marinarierav/DriveArt/docs/report_sprint2.pdf

## DRIVE ART

### Sprint #2

### 8 Mayo 2019

### Stefany Ariana Chóez Bolaños 1459134

### Daniel Panadero Espinosa 1458674

### César Valcarce Pagán 1388811 Marina Riera Velasco 1457466

# Contents

1

RLP - Computer Engineering. UAB (Barcelona) 2018-2019 | Drive Art

## Descripción del proyecto

Drive Art es un coche robot (con cierta autonomía) que permite dibujar con los gestos que hagamos con la cabeza (dibujo en físico). Drive Art dispone de dos sensores de ultrasonidos que permitirá que el coche evite obstáculos para no chocarse. Por otra parte, teniendo en cuenta que el dibujo que se realizará con los gestos puede no ser perfecto, ya que este proyecto se ha pensado para una posible utilidad para las personas con paraplejia, se realzará un filtrado para arreglar el dibujo que se haya hecho y se mostrará por pantalla el resultado final.

## Componentes electrónicos

- Arduino nano
- HC-SR04 ultrasonic sensor
- Motor shield l298n
- Motores DC y ruedas
- Baterías AA recargables
- Base para baterías
- Módulo wifi
- Micro servo SG90
- Cables

Page 2 of 11

RLP - Computer Engineering. UAB (Barcelona) 2018-2019 | Drive Art

## Esquema Hardware

A continuación, se muestra el esquema de conexiones de nuestro robot.

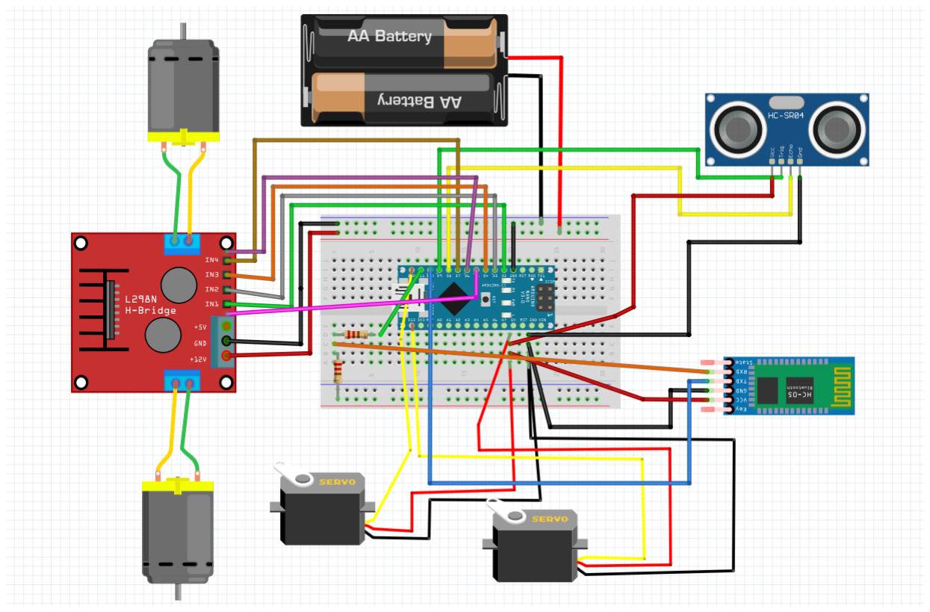
[picture p12: figure]

Figure 1: Esquema de connexiones de los componentes.

Page 3 of 11

RLP - Computer Engineering. UAB (Barcelona) 2018-2019 | Drive Art

## Arquitectura Software

A continuación, se muestran los distintos módulos software que usaremos y cómo se comunican entre ellos y con los distintos dispositivos.


Figure 2: Esquema de módulos software.

Page 4 of 11

RLP - Computer Engineering. UAB (Barcelona) 2018-2019 | Drive Art

## Otros Esquemas: sketch del robot

A continuación, se muestra un sketch inicial del concepto de nuestro robot, con las medidas de los componentes.


Figure 3: Sketch inicial del robot (cotas en milímetros).

Page 5 of 11

RLP - Computer Engineering. UAB (Barcelona) 2018-2019 | Drive Art

## Contribuciones

Como se ha comentado en la descripción del proyecto, DriveArt consiste en un coche robot que permita dibujar, y que se controla mediante los gestos de la cabeza. Está basado no en un sólo proyecto, sinó en una combinación de varios (consultar sección referencias). De modo que nuestra principal contribución ha sido la de unificar todos estos proyectos en uno solo, y al mismo tiempo permitir que el robot dibuje en físico.

Por otra parte, otra contribución notable será la de aplicar un filtrado al dibujo resultante (similar al proyecto "Fishes Can Drive Too", de RLP 2018) y mostrarlo por pantalla. El filtrado puede consistir en eliminación de ruido (especialmente al ser para personas con paraplejía, que pueden realizar algunos movimientos involuntários) y suavizar las líneas del dibujo.

Para el control del robot, se necesita comunicar el robot utilizando un módulo WIFI:

- Por una parte, con una aplicación móbil que le enviará al robot los datos de los gestos realizados con la cabeza, recogidos mediante un accelerómetro interno.
- Por otra parte, con un servidor que es el que recogerá el dibujo que realiza el robot, y que aplicará el filtrado descrito.

Finalmente, la nota a la cual aspiramos, cumpliendo con todos los objetivos y funcionalidades que nos hemos planteado, es el 10, porque consideramos que el proyecto es muy completo tanto a nivel hardware como a nivel software, y además se han propuesto varias contribuciones muy significativas, que añaden valor al proyecto, haciendo que destaque y se distinja de los que se pueden encontrar en internet.

También hemos relacionado el proyecto con otra asignatura de nuestra mención (APC, Aprendizaje Computacional), de la cual aprovecharemos algunos conocimientos para realizar algún filtraje tipo "smoothing" o de regresión (ya sea lineal o polinómica). Asimismo, tambiíen se aprovecharán conocimientos de otra asignatura fuera de la mención (Web) para desarollar la aplicación móbil y configurar el servidor.

Page 6 of 11

RLP - Computer Engineering. UAB (Barcelona) 2018-2019 | Drive Art

## Extra components and 3D pieces

- Chasis del coche (impreso en 3D)

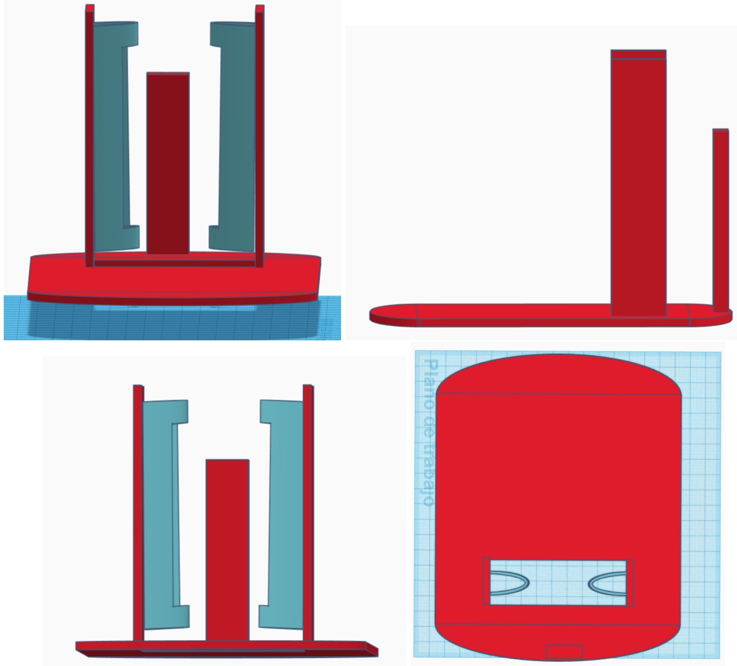
[picture p13: figure]

Figure 4: Modelo 3D del chasis del coche robot

- Estructura de engranajes para realizar la funcionalidad del cambio de color (tomados del laboratorio)
- Rueda loca (comprada)
- Mini breadboard para realizar todas las connexiones

Page 7 of 11

RLP - Computer Engineering. UAB (Barcelona) 2018-2019 | Drive Art

## Riesgos previstos y planes de contingencia

A continuación, analizamos los riesgos que se prevé que podrían ocurrir en el proyecto, recogidos en la siguiente tabla:

Riesgo | Descripción | Probabilidad | Impacto | Plan contingencia
1 | Desviación del coche provocada por diferente rendimiento entre los dos motores | Media | Alto | Habrá que calibrar los motores previamente, adaptando la velocidad de cada uno para que el coche se mueva en línea recta.
2 | Cambio color no funcional (a causa de la transmisión de los engranajes o por falta de potencia del servo) | Baja | Medio | Simular el cambio de color sólo en pantalla y no en físico (rebajando ligeramente la ambición inicial).
3 | En caso de que se necesite un pin adicional para RST del módulo WiFi, nos faltaria un pin | Media/Alta | Bajo | Eliminar algún componente no esencial, como el sensor de ultrasonidos secundario (el de detrás).
4 | Falta de precisión al realizar el dibujo (ya sea por cómo se recogen los gestos con el accelerómetro, o por falta de precisión del robot) | Media | Bajo | Aplicar un filtrado más potente/agresivo para suavizar, aunque el dibujo no quedará tan bien.
5 | No poder realizar el filtrado a tiempo real | Media/Alta | Bajo | El dibujo en físico es más visual, de modo que no supone un inconveniente si el filtrado se realiza una vez acabado el dibujo y se puestra por pantalla al final.

Table 1: Tabla de riesgos y plan de contingencia.

Page 8 of 11

RLP - Computer Engineering. UAB (Barcelona) 2018-2019 | Drive Art

## Códigos

En este apartado se mostrarán todos los códigos que se han utilizado para probar cada una de las partes del robot.

Movimiento robot | Sensores HC-SR04

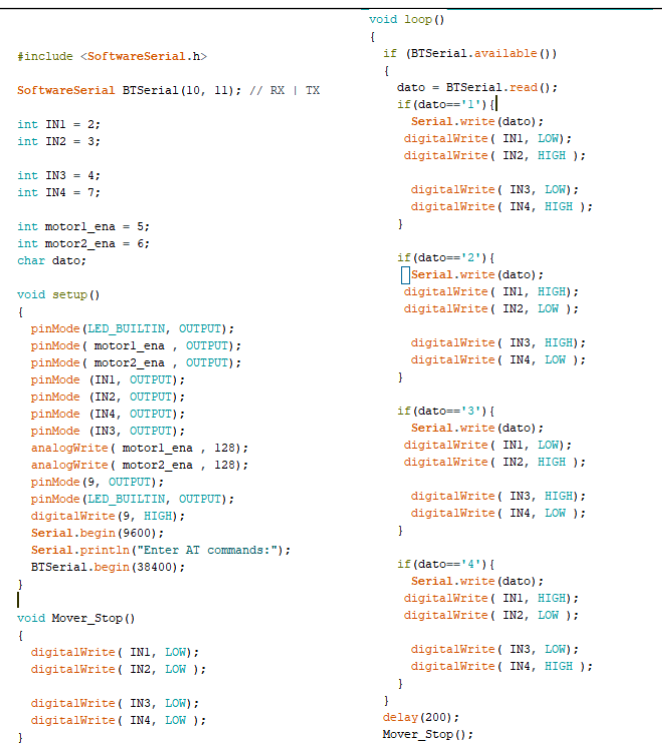
[picture p14: figure]
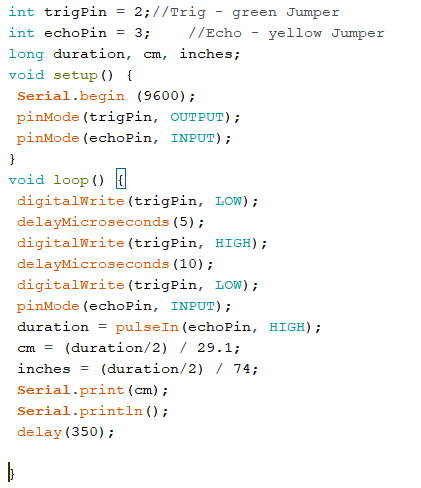
[picture p15: figure]
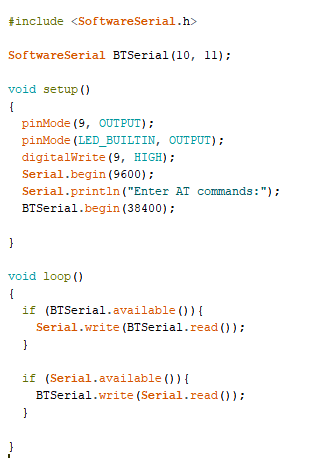
[picture p16: figure]
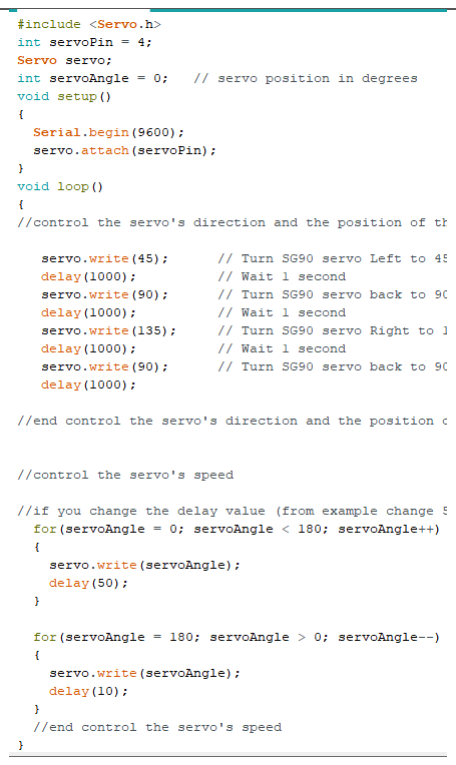
[picture p17: figure]

Modúlo Bluetooth | Servos

Page 9 of 11

RLP - Computer Engineering. UAB (Barcelona) 2018-2019 | Drive Art

## Sprint #2

Para el entregable del sprint 2 hemos podido observar diferentes aspectos del robot que fallaban en cuanto al diseño del sprint anterior y gracias a esto hemos podido rediseñar el robot que esperemos nos ayudará a conseguir nuestro objetivo para el siguente sprint. Por una parte, el mecanismo que habíamos planteado inicialmente para mover los lapices y poder pintar era incorrecto ya que al implementarlo en fisico y poner en funcionamiento el servo los lapices no se aguantaban y acababan cayéndose.
Por otra parte, nos ha resultado un poco complicado utilizar el modúlo de bluetooth para comunicarnos con el arduino nano pero finalmente hemos conseguido comunicarnos con el arduino mediante el móvil. Además, para este sprint no hemos podido lograr que el robot se mueva como nosotros deseábamos mediante gestos con el acelerometro ya que al implemetarlo y por ejemplo, haciamos el gesto de ir hacia delante el robot se movía pero no paraba hasta un cierto tiempo.

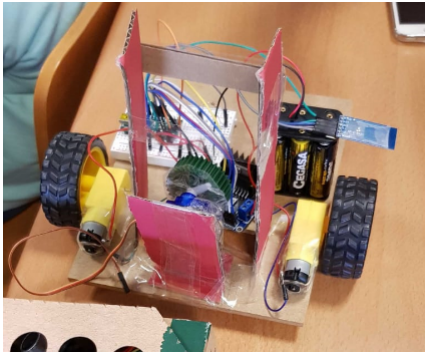
[picture p18: figure]

Page 10 of 11

RLP - Computer Engineering. UAB (Barcelona) 2018-2019 | Drive Art

## Referencias

El proyecto ha estado inspirado, principalmente, como una combinación de los siguientes proyectos de internet:

1. Human Head to Robot Head: https://create.arduino.cc/projecthub/jegatheesan/

human-head-to-robot-head-364bfd?ref=\search&ref_id=head%20control&offset=

5

2. Obstacle Avoiding Robot:

https://www.instructables.com/id/Arduino-Ultimate-Obstacle-Avoiding-Robot/

3. CNC Drawing Arm: https://www.instructables.com/id/CNC-Drawing-Arm/
4. Fishes Can Drive Too: https://rlpengineeringschooluab2018.wordpress.com/

2018/05/29/fishes-can-drive-too/ (https://rlpengineeringschooluab2018.wordpress.com/2018/05/29/fishes-can-drive-too/)

Page 11 of 11
