marinarierav/DriveArt/src/pages/canvas/spaceship.png

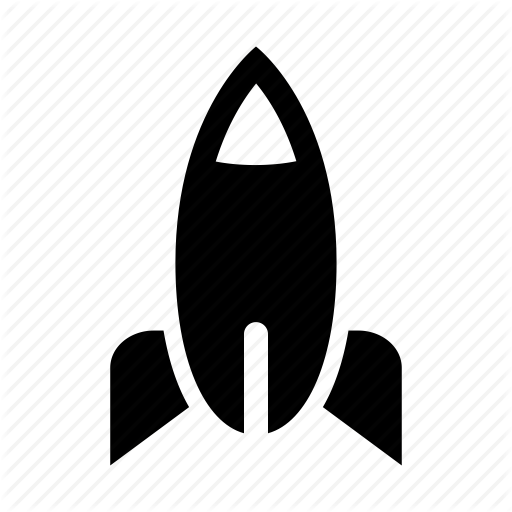
src/pages/canvas/spaceship.png
