marinarierav/DriveArt/(commit log)

2019-05-13 feat: get directions from accelerometre
2019-05-13 feat: button to switch brush colors
2019-05-13 feat: canvas allows drawing via device motion
    needs refining.. maybe use sin/cos functions for trajectory calc
2019-05-20 feat: add button to apply filtering (bezier) to the finished drawing
2019-05-20 fix: fixed crash on filter
2019-05-21 fix: first point of the filter was bugged due to wrong offsets
2019-05-21 feat: color buttons now control two servos in the arduino
2019-05-28 modified accelerometre frequency
2019-05-28 add arduino code and docs
